ihsanalhafiz/Krakatau-Board-v1.3/PCBWay-BOM KrakatauBoardv1.3.xlsx

 |  |  | Bill of Materials Krakatau Board v1.3
Item # | *Designator | *Qty | Manufacturer | *Mfg Part # | Description / Value | *Package/Footprint | Type | Your Instructions / Notes
1 | U1 | 1 | STMicroelectronics | STM32F413VHT6 | IC MCU 32BIT 1.5MB FLASH 100LQFP | 100-LQFP | SMD |  | https://www.digikey.com/product-detail/en/stmicroelectronics/STM32F413VHT6/497-17010-ND/6564702
2 | SW1 | 1 | E-Switch | TL3342F160QG/TR | SWITCH TACTILE SPST-NO 0.05A 12V |  | SMD |  | https://www.digikey.com/product-detail/en/e-switch/TL3342F160QG-TR/EG2531CT-ND/379004
3 | C1,C2 | 2 | Murata Electronics | GRM155R61A225KE95D | CAP CER 2.2UF 10V X5R 0402 | 0402 | SMD |  | https://www.digikey.com/product-detail/en/murata-electronics/GRM155R61A225KE95D/490-10451-1-ND/5026361
4 | BT1, BT2 | 2 | Harwin Inc. | S8411-45R | BATTERY HOLDER COIN 12MM SMD |  | SMD | Please include battery CR1220 in PCB Board | https://www.digikey.com/product-detail/en/harwin-inc/S8411-45R/952-1745-1-ND/3131073
5 | Y1 | 1 | ECS Inc. | ECS-250-20-33-CKM-TR | CRYSTAL 25.0000MHZ 20PF SMD | 4-SMD | SMD |  | https://www.digikey.com/product-detail/en/ecs-inc/ECS-250-20-33-CKM-TR/XC1817CT-ND/2781942
6 | Y2 | 1 | ECS Inc. | ECS-.327-12.5-34B-TR | CRYSTAL 32.7680KHZ 12.5PF SMD | 2-SMD | SMD |  | https://www.digikey.com/product-detail/en/ecs-inc/ECS-327-12-5-34B-TR/XC1617CT-ND/1693786
7 | C4, C5 | 2 | Murata Electronics | GJM1555C1H200JB01D | CAP CER 20PF 50V C0G/NP0 0402 | 0402 | SMD |  | https://www.digikey.com/product-detail/en/murata-electronics/GJM1555C1H200JB01D/490-3120-1-ND/702386
8 | C6,C7 | 2 | Murata Electronics | GCM1555C1H120FA16J | CAP CER 12PF 50V C0G/NP0 0402 | 0402 | SMD |  | https://www.digikey.com/product-detail/en/murata-electronics/GCM1555C1H120FA16J/490-16459-1-ND/7363441
9 | C8 | 1 | KEMET | C1210T475K5RAC7800 | CAP CER 4.7UF 50V X7R 1210 | 1210 | SMD |  | https://www.digikey.com/product-detail/en/kemet/C1210T475K5RAC7800/399-20366-1-ND/9925808
10 | C3, C9, C10, C11, C12, C13, C14, C15, C16, C17, C18, C19, C22, C23, C24, C31, C47, C49, C59, C60, C61 | 21 | KEMET | C0402T104K4RAC7867 | CAP CER 0.1UF 16V X7R 0402 | 0402 | SMD |  | https://www.digikey.com/product-detail/en/kemet/C0402T104K4RAC7867/399-17387-1-ND/8570354
11 | C20, C21, C32, C34, C35, C36, C37, C38, C39, C40, C41, C42, C43 | 13 | KEMET | C0603C105K8RACAUTO | CAP CER 0603 1UF 10V X7R 10% | 0603 | SMD |  | https://www.digikey.com/product-detail/en/kemet/C0603C105K8RACAUTO/399-17705-1-ND/8635856
12 | R1, R9, R10,R11,R12, R13, R14 | 7 | Vishay Dale | TNPW040210K0BETD | RES 10K OHM 0.1% 1/16W 0402 | 0402 | SMD |  | https://www.digikey.com/product-detail/en/vishay-dale/TNPW040210K0BETD/541-3559-1-ND/7354920
13 | U2 | 1 | Texas Instruments | LM3671MF-3.3/NOPB | IC REG BUCK 3.3V 600MA SOT23-5 | SOT23-5 | SMD |  | https://www.digikey.com/product-detail/en/texas-instruments/LM3671MF-3-3-NOPB/LM3671MF-3-3-NOPBCT-ND/1590190
14 | R2, R3, R5 | 3 | Vishay Dale | TNPW0402100KBETD | RES 100K OHM 0.1% 1/16W 0402 | 0402 | SMD |  | https://www.digikey.com/product-detail/en/vishay-dale/TNPW0402100KBETD/541-3558-1-ND/7354919
15 | C25 | 1 | KEMET | C0805C475K4RACTU | CAP CER 4.7UF 16V X7R 0805 | 0805 | SMD |  | https://www.digikey.com/product-detail/en/kemet/C0805C475K4RACTU/399-7415-1-ND/3317449
16 | C26 | 1 | KEMET | C0805C106M8RACAUTO | CAP CER 10UF 10V X7R 0805 | 0805 | SMD |  | https://www.digikey.com/product-detail/en/kemet/C0805C106M8RACAUTO/399-15690-1-ND/7427570
17 | U3 | 1 | Texas Instruments | LMR33630ADDAR | IC REG BUCK ADJUSTABLE 3A 8SOPWR | 8SOPWR | SMD |  | https://www.digikey.com/product-detail/en/texas-instruments/LMR33630ADDAR/296-49763-1-ND/9462677
18 | C27 | 1 | Würth Elektronik | 865230542002 | CAP 10 UF 20% 35 V | Radial | SMD |  | https://www.digikey.com/product-detail/en/w%C3%BCrth-elektronik/865230542002/732-8295-1-ND/5728252
19 | C28 | 1 | KEMET | C0805C224K5RACAUTO | CAP CER 0.22UF 50V X7R 0805 | 0805 | SMD |  | https://www.digikey.com/product-detail/en/kemet/C0805C224K5RACAUTO/399-6949-1-ND/3314457
20 | C29, C30, C63, C64 | 4 | Taiyo Yuden | LMK212BBJ226MD-T | CAP CER 22UF 10V X5R 0805 | 0805 | SMD |  | https://www.digikey.com/product-detail/en/taiyo-yuden/LMK212BBJ226MD-T/587-5917-1-ND/7675037
21 | R4 | 1 | TE Connectivity Passive Product | RN73C1E24K9BTD | RES SMD 24.9KOHM 0.1% 1/16W 0402 | 0402 | SMD |  | https://www.digikey.com/product-detail/en/te-connectivity-passive-product/RN73C1E24K9BTD/A124622CT-ND/6558382
22 | L1, L2 | 2 | Würth Elektronik | 78438356022 | FIXED IND 2.2UH 4.7A 35 MOHM SMD |  | SMD |  | https://www.digikey.com/product-detail/en/w%C3%BCrth-elektronik/78438356022/732-11314-1-ND/6833773
23 | D2, D5 | 2 | Nexperia USA Inc. | PMEG3050EP,115 | DIODE SCHOTTKY 30V 5A SOD128 | SOD128 | SMD |  | https://www.digikey.com/product-detail/en/nexperia-usa-inc/PMEG3050EP-115/1727-5317-1-ND/2676793
24 | U4 | 1 | Texas Instruments | REF2933AIDBZR | IC VREF SERIES 2% SOT23-3 | SOT23-3 | SMD |  | https://www.digikey.com/product-detail/en/texas-instruments/REF2933AIDBZR/296-41482-1-ND/5222875
25 | C33 | 1 | Murata Electronics | GRM155R71A474KE01D | CAP CER 0.47UF 10V X7R 0402 | 0402 | SMD |  | https://www.digikey.com/product-detail/en/murata-electronics/GRM155R71A474KE01D/490-14366-1-ND/6606827
26 | U5 | 1 | Fanstel Corp. | BT832XE | RX TXRX MOD BLE 5 U.FL SMD |  | SMD |  | https://www.digikey.com/product-detail/en/fanstel-corp/BT832XE/1914-1016-1-ND/8323669
27 | R6 | 1 | Keystone Electronics | 5112 | 0402 JUMPER ON TAPE AND REEL | 0402 | SMD |  | https://www.digikey.com/product-detail/en/keystone-electronics/5112/36-5112-1-ND/9921855
28 | U6, U7 | 2 | Texas Instruments | MAX232ECDW | IC TRANSCEIVER FULL 2/2 16SOIC | 16SOIC | SMD |  | https://www.digikey.com/product-detail/en/texas-instruments/MAX232ECDW/296-33358-5-ND/1511009
29 | U8 | 1 | FTDI, Future Technology Devices International Ltd | FT234XD-R | IC USB SERIAL BASIC UART 12DFN | 12-DFN | SMD |  | https://www.digikey.com/product-detail/en/ftdi-future-technology-devices-international-ltd/FT234XD-R/768-1178-1-ND/3904926
30 | L3 | 1 | Würth Elektronik | 742792651 | FERRITE BEAD 600 OHM 0603 1LN | 0603 | SMD |  | https://www.digikey.com/product-detail/en/w%C3%BCrth-elektronik/742792651/732-1593-1-ND/1639537
31 | R7, R8 | 2 | TE Connectivity Passive Product | CRGP0402F27R | CRGP 0402 27R 1% | 0402 | SMD |  | https://www.digikey.com/product-detail/en/te-connectivity-passive-product/CRGP0402F27R/A130336CT-ND/8578168
32 | C44, C45 | 2 | KEMET | C0402C470K5GACTU | CAP CER 47PF 50V C0G/NP0 0402 | 0402 | SMD |  | https://www.digikey.com/product-detail/en/kemet/C0402C470K5GACTU/399-7796-1-ND/3471519
33 | C46, C50 | 2 | KEMET | C0402C103M5RACTU | CAP CER 10000PF 50V X7R 0402 | 0402 | SMD |  | https://www.digikey.com/product-detail/en/kemet/C0402C103M5RACTU/399-7760-1-ND/3471483
34 | C48 | 1 | Würth Elektronik | 885012105008 | CAP CER 4.7UF 6.3V X5R 0402 | 0402 | SMD |  | https://www.digikey.com/product-detail/en/w%C3%BCrth-elektronik/885012105008/732-7485-1-ND/5454112
35 | U9 | 1 | Maxim Integrated | MAX5490VB10000+T | RES NTWRK 2 RES MULT OHM TO236-3 | TO236-3 | SMD |  | https://www.digikey.com/product-detail/en/stmicroelectronics/TESEO-LIV3F/497-18163-1-ND/9556693
36 | U10 | 1 | STMicroelectronics | TESEO-LIV3F | RF RCVR GNSS/GPS 1.575GHZ 18LCC |  | SMD |  | https://www.digikey.com/product-detail/en/stmicroelectronics/TESEO-LIV3F/497-18163-1-ND/9556693
37 | L4 | 1 | Murata Electronics | LQG15HS27NJ02D | FIXED IND 27NH 350MA 460 MOHM | 0402 | SMD |  | https://www.digikey.com/product-detail/en/murata-electronics/LQG15HS27NJ02D/490-2628-1-ND/662908
38 | C51, C52, C53, C54. C55 | 5 | KEMET | C0402C560K5RAC7867 | CAP CER 56PF 50V X7R 0402 | 0402 | SMD |  | https://www.digikey.com/product-detail/en/kemet/C0402C560K5RAC7867/399-C0402C560K5RAC7867CT-ND/11504529
39 | C56, C57 | 2 | Knowles Novacap | C04BL121X-5SN-X0T | CAP CER 120PF 50V 0402 | 0402 | SMD |  | https://www.digikey.com/product-detail/en/knowles-novacap/C04BL121X-5SN-X0T/1761-1074-1-ND/7596237
40 | FL1 | 1 | Taiyo Yuden | F6QA1G582H2JM-J | FILTER SAW 1.582GHZ 5SMD |  | SMD |  | https://www.digikey.com/product-detail/en/taiyo-yuden/F6QA1G582H2JM-J/587-3990-1-ND/4963980
41 | U11 | 1 | Infineon Technologies | BGA725L6E6327FTSA1 | IC AMP GPS 1.55-1.615GHZ TSLP6-2 | TSLP6-2 | SMD |  | https://www.digikey.com/product-detail/en/infineon-technologies/BGA725L6E6327FTSA1/BGA725L6E6327FTSA1CT-ND/3911501
42 | L5 | 1 | Murata Electronics | LQW15AN5N6C10D | FIXED IND 5.6NH 800MA 51 MOHM | 0402 | SMD |  | https://www.digikey.com/product-detail/en/murata-electronics/LQW15AN5N6C10D/490-6833-1-ND/3846030
43 | C58 | 1 | KEMET | C0402C102K5RACTU | CAP CER 1000PF 50V X7R 0402 | 0402 | SMD |  | https://www.digikey.com/product-detail/en/kemet/C0402C102K5RACTU/399-1032-1-ND/411307
44 | Y3, Y4, Y5 | 3 | Hirose Electric Co Ltd | U.FL-R-SMT-1(10) | CONN U.FL RCPT STR 50 OHM SMD |  | SMD |  | https://www.digikey.com/product-detail/en/hirose-electric-co-ltd/U-FL-R-SMT-1-10/H11891CT-ND/2504612
45 | U12 | 1 | Maxim Integrated | DS3231SN#T&R | IC RTC CLK/CALENDAR I2C 16-SOIC | 16-SOIC | SMD |  | https://www.digikey.com/product-detail/en/maxim-integrated/DS3231SN-T-R/DS3231SN-T-RCT-ND/3894827
46 | U13 | 1 | Microchip Technology | 24LC01BT-E/OT | IC EEPROM 1K I2C 400KHZ SOT23-5 | SOT23-5 | SMD |  | https://www.digikey.com/product-detail/en/microchip-technology/24LC01BT-E-OT/24LC01BT-E-OTCT-ND/7065550
47 | U14 | 1 | Linear Technology/Analog Devices | LTC4151IMS#TRPBF | IC CURRENT MONITOR(12BIT) 10MSOP | 10MSOP | SMD |  | https://www.digikey.com/product-detail/en/linear-technology-analog-devices/LTC4151IMS-TRPBF/LTC4151IMS-TRPBFCT-ND/8258439
48 | RS1 | 1 | Stackpole Electronics Inc | HCSM2818FT20L0 | RES 0.02 OHM 5W 1% 2818 SMD | 2818 | SMD |  | https://www.digikey.com/product-detail/en/stackpole-electronics-inc/HCSM2818FT20L0/HCSM2818FT20L0CT-ND/9557201
49 | R15, R16 | 2 | Vishay Dale | TNPW04022K00BEED | RES 2K OHM 0.1% 1/16W 0402 | 0402 | SMD |  | https://www.digikey.com/product-detail/en/vishay-dale/TNPW04022K00BEED/TNP2-00KDACT-ND/1857046
50 | T1 | 1 | Vishay Siliconix | SUM110P06-07L-E3 | MOSFET P-CH 60V 110A D2PAK | D2PAK | SMD |  | https://www.digikey.com/product-detail/en/vishay-siliconix/SUM110P06-07L-E3/SUM110P06-07L-E3CT-ND/1656732
51 | R17 | 1 | Vishay Dale | TNPW0603100KBETA | RES 100K OHM 0.1% 1/10W 0603 | 0603 | SMD |  | https://www.digikey.com/product-detail/en/vishay-dale/TNPW0603100KBETA/541-3570-1-ND/7354930
52 | D3 | 1 | Diodes Incorporated | BZT52C12-13-F | DIODE ZENER 12V 500MW SOD123 | SOD123 | SMD |  | https://www.digikey.com/product-detail/en/diodes-incorporated/BZT52C12-13-F/BZT52C1213-FDICT-ND/1852057
53 | U15 | 1 | ON Semiconductor | MMBT2907ALT1G | TRANS PNP 60V 0.6A SOT23 | SOT23 | SMD |  | https://www.digikey.com/product-detail/en/on-semiconductor/MMBT2907ALT1G/MMBT2907ALT1GOSCT-ND/1139812
54 | D4 | 1 | Infineon Technologies | ESD234B1W0201E6327XTSA1 | TVS DIODES |  | SMD |  | https://www.digikey.com/product-detail/en/infineon-technologies/ESD234B1W0201E6327XTSA1/ESD234B1W0201E6327XTSA1CT-ND/9974934
55 | R18 | 1 | Vishay Dale | TNPW040220K0BEED | RES 20K OHM 0.1% 1/16W 0402 | 0402 | SMD |  | https://www.digikey.com/product-detail/en/vishay-dale/TNPW040220K0BEED/TNP20-0KDACT-ND/1857043
56 | R19, R20 | 2 | Vishay Dale | CRCW0402560KFKED | RES SMD 560K OHM 1% 1/16W 0402 | 0402 | SMD |  | https://www.digikey.com/product-detail/en/vishay-dale/CRCW0402560KFKED/541-560KLCT-ND/1183436
57 | R21 | 1 | Vishay Dale | CRCW04020000Z0EDHP | RES SMD 0 OHM JUMPER 1/5W 0402 | 0402 | SMD |  | https://www.digikey.com/product-detail/en/vishay-dale/CRCW04020000Z0EDHP/541-0-0YBCT-ND/2223008
58 | U16 | 1 | STMicroelectronics | IIS328DQTR | ACCELEROMETER 2-8G I2C/SPI 24QFN | 24QFN | SMD |  | https://www.digikey.com/product-detail/en/stmicroelectronics/IIS328DQTR/497-15701-1-ND/5267987
59 | C62 | 1 | KEMET | C0402C106M9PAC7867 | CAP CER 10UF 6.3V X5R 0402 | 0402 | SMD |  | https://www.digikey.com/product-detail/en/kemet/C0402C106M9PAC7867/399-13069-1-ND/5767556
60 | J12 | 1 | Samtec Inc. | CLP-110-02-FM-D-P-TR | CONN RCPT 20POS 0.05 GOLD SMD |  | SMD |  | https://www.digikey.com/product-detail/en/samtec-inc/CLP-110-02-FM-D-P-TR/CLP-110-02-FM-D-P-TR-ND/6704150
61 | J10 | 1 | Würth Elektronik | 693071020811 | SMT MICRO SD CARD CONNECTOR, PUS |  | SMD |  | https://www.digikey.com/product-detail/en/w%C3%BCrth-elektronik/693071020811/732-693071020811CT-ND/11631970
62 | J1, J2 | 2 | Samtec Inc. | MMCX-P-P-H-ST-TH1 | CONN MMCX PLUG STR 50 OHM PCB |  | Through Hole |  | https://www.digikey.com/product-detail/en/samtec-inc/MMCX-P-P-H-ST-TH1/SAM10618-ND/6561612
63 | J3, J5, J11, J13 | 4 | Sullins Connector Solutions | SWR25X-NRTC-S02-RB-BA | CONN HEADER R/A 2POS 2.54MM |  | Through Hole |  | https://www.digikey.com/product-detail/en/sullins-connector-solutions/SWR25X-NRTC-S02-RB-BA/S9499-ND/2769660
64 | J4, J6, J7, J14 | 4 | Sullins Connector Solutions | SWR25X-NRTC-S03-RB-BA | CONN HEADER R/A 3POS 2.54MM |  | Through Hole |  | https://www.digikey.com/product-detail/en/sullins-connector-solutions/SWR25X-NRTC-S03-RB-BA/S9403-ND/2769661
65 | J9 | 1 | Sullins Connector Solutions | SWR25X-NRTC-S04-ST-BA | CONN HEADER VERT 4POS 2.54MM |  | Through Hole |  | https://www.digikey.com/product-detail/en/sullins-connector-solutions/SWR25X-NRTC-S04-ST-BA/S9410-ND/2769654
66 | J8 | 1 | Würth Elektronik | 61300511121 | CONN HEADER VERT 5POS 2.54MM |  | Through Hole |  | https://www.digikey.com/product-detail/en/w%C3%BCrth-elektronik/61300511121/732-5318-ND/4846831
67 | J15 | 1 | Würth Elektronik | 61300311121 | CONN HEADER VERT 3POS 2.54MM |  | Through Hole |  | https://www.digikey.com/product-detail/en/w%C3%BCrth-elektronik/61300311121/732-5316-ND/4846825
