ihsanalhafiz/Krakatau-Board-v1.3/Krakatau Board v1.3.brd

## EAGLE design Krakatau Board v1.3.brd (2020-05-09)

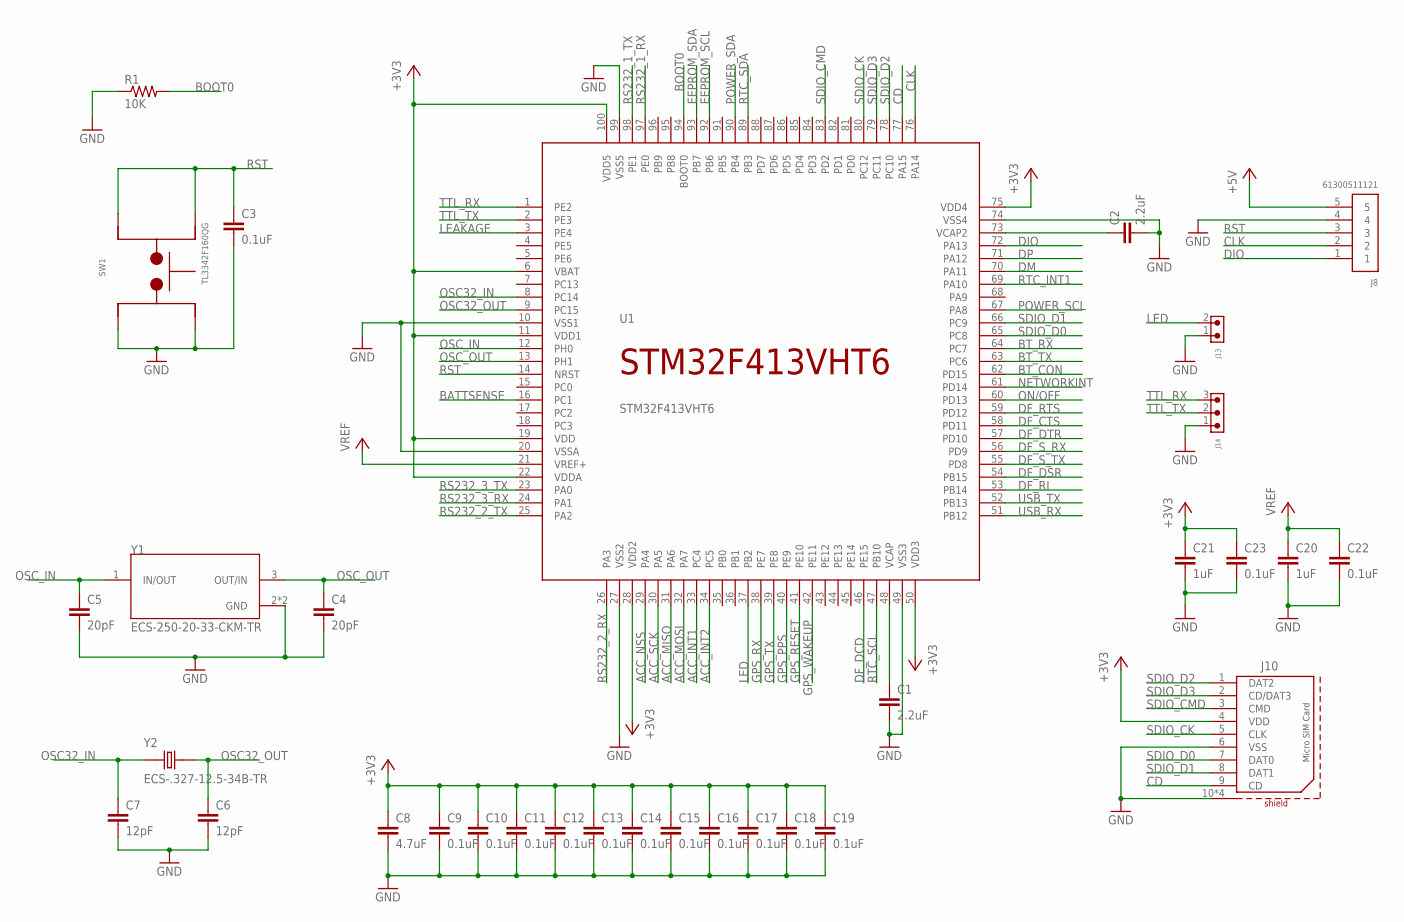
[picture p1: schematic Krakatau Board v1.3.sch, sheet 1, Microcontroller STM32F413VHT6]

Parts:
C1, C2: 2.2uF; CAPC1005X50N-0402-KEMET
C3, C9, C10, C11, C12, C13, C14, C15, C16, C17, C18, C19, C22, C23: 0.1uF; CAPC1005X50N-0402-KEMET
C4, C5: 20pF; CAPC1005X50N-0402-KEMET
C6, C7: 12pF; CAPC1005X50N-0402-KEMET
C8: 4.7uF; CAPC3225X90N-1210-KEMET
C20, C21: 1uF; CAPC1608X80N-0603-KEMET
J8: 61300511121
J10: 693071020811
J13: 61900211121
J14: 61900311121
R1: 10K; RESC1005X35N-0402-VISHAYDALE
SW1: TL3342F160QG; SW_TL3342F160QG
U1: STM32F413VHT6; QFP50P1590X1590X160-100N
Y1: ECS-250-20-33-CKM-TR; XTAL_ECS-250-20-33-CKM-TR
Y2: ECS-.327-12.5-34B-TR; XTAL_ECS-.327-12.5-34B-TR

Connections:
+3V3: C8.1, C9.1, C10.1, C11.1, C12.1, C13.1, C14.1, C15.1, C16.1, C17.1, C18.1, C19.1, C21.1, C23.1, J10.4 (VDD), U1.6 (VBAT), U1.11 (VDD1), U1.19 (VDD), U1.22 (VDDA), U1.28 (VDD2), U1.50 (VDD3), U1.75 (VDD4), U1.100 (VDD5); also elsewhere on the board
+5V: J8.5; also elsewhere on the board
ACC_INT1: U1.33 (PC4); also elsewhere on the board
ACC_INT2: U1.34 (PC5); also elsewhere on the board
ACC_MISO: U1.31 (PA6); also elsewhere on the board
ACC_MOSI: U1.32 (PA7); also elsewhere on the board
ACC_NSS: U1.29 (PA4); also elsewhere on the board
ACC_SCK: U1.30 (PA5); also elsewhere on the board
BATTSENSE: U1.16 (PC1); also elsewhere on the board
BOOT0: R1.2, U1.94 (BOOT0)
BT_CON: U1.62 (PD15); also elsewhere on the board
BT_RX: U1.64 (PC7); also elsewhere on the board
BT_TX: U1.63 (PC6); also elsewhere on the board
CD: J10.9 (CD), U1.77 (PA15)
CLK: J8.2, U1.76 (PA14)
DF_CTS: U1.58 (PD11); also elsewhere on the board
DF_DCD: U1.46 (PE15); also elsewhere on the board
DF_DSR: U1.54 (PB15); also elsewhere on the board
DF_DTR: U1.57 (PD10); also elsewhere on the board
DF_RI: U1.53 (PB14); also elsewhere on the board
DF_RTS: U1.59 (PD12); also elsewhere on the board
DF_S_RX: U1.56 (PD9); also elsewhere on the board
DF_S_TX: U1.55 (PD8); also elsewhere on the board
DIO: J8.1, U1.72 (PA13)
DM: U1.70 (PA11)
DP: U1.71 (PA12)
EEPROM_SCL: U1.92 (PB6); also elsewhere on the board
EEPROM_SDA: U1.93 (PB7); also elsewhere on the board
GND: C1.2, C2.2, C3.2, C4.2, C5.2, C6.2, C7.2, C8.2, C9.2, C10.2, C11.2, C12.2, C13.2, C14.2, C15.2, C16.2, C17.2, C18.2, C19.2, C20.2, C21.2, C22.2, C23.2, J8.4, J10.6 (VSS), J10.10 (SHIELD), J10.11 (SHIELD), J10.12 (SHIELD), J10.13 (SHIELD), J13.1, J14.1, R1.1, SW1.1, SW1.2, U1.10 (VSS1), U1.20 (VSSA), U1.27 (VSS2), U1.49 (VSS3), U1.74 (VSS4), U1.99 (VSS5), Y1.2 (GND), Y1.4 (GND); also elsewhere on the board
GPS_PPS: U1.40 (PE9); also elsewhere on the board
GPS_RESET: U1.41 (PE10); also elsewhere on the board
GPS_RX: U1.38 (PE7); also elsewhere on the board
GPS_TX: U1.39 (PE8); also elsewhere on the board
GPS_WAKEUP: U1.42 (PE11); also elsewhere on the board
LEAKAGE: U1.3 (PE4); also elsewhere on the board
LED: J13.2, U1.37 (PB2)
unnamed: C2.1, U1.73 (VCAP2)
unnamed: C1.1, U1.48 (VCAP)
NETWORKINT: U1.61 (PD14); also elsewhere on the board
ON/OFF: U1.60 (PD13); also elsewhere on the board
OSC32_IN: C7.1, U1.8 (PC14), Y2.1
OSC32_OUT: C6.1, U1.9 (PC15), Y2.2
OSC_IN: C5.1, U1.12 (PH0), Y1.1 (IN/OUT)
OSC_OUT: C4.1, U1.13 (PH1), Y1.3 (OUT/IN)
POWER_SCL: U1.67 (PA8); also elsewhere on the board
POWER_SDA: U1.90 (PB4); also elsewhere on the board
RS232_1_RX: U1.97 (PE0); also elsewhere on the board
RS232_1_TX: U1.98 (PE1); also elsewhere on the board
RS232_2_RX: U1.26 (PA3); also elsewhere on the board
RS232_2_TX: U1.25 (PA2); also elsewhere on the board
RS232_3_RX: U1.24 (PA1); also elsewhere on the board
RS232_3_TX: U1.23 (PA0); also elsewhere on the board
RST: C3.1, J8.3, SW1.3, SW1.4, U1.14 (NRST)
RTC_INT1: U1.69 (PA10); also elsewhere on the board
RTC_SCL: U1.47 (PB10); also elsewhere on the board
RTC_SDA: U1.89 (PB3); also elsewhere on the board
SDIO_CK: J10.5 (CLK), U1.80 (PC12)
SDIO_CMD: J10.3 (CMD), U1.83 (PD2)
SDIO_D0: J10.7 (DAT0), U1.65 (PC8)
SDIO_D1: J10.8 (DAT1), U1.66 (PC9)
SDIO_D2: J10.1 (DAT2), U1.78 (PC10)
SDIO_D3: J10.2 (CD/DAT3), U1.79 (PC11)
TTL_RX: J14.3, U1.1 (PE2)
TTL_TX: J14.2, U1.2 (PE3)
USB_RX: U1.51 (PB12); also elsewhere on the board
USB_TX: U1.52 (PB13); also elsewhere on the board
VCC: C20.1, C22.1, U1.21 (VREF+); also elsewhere on the board

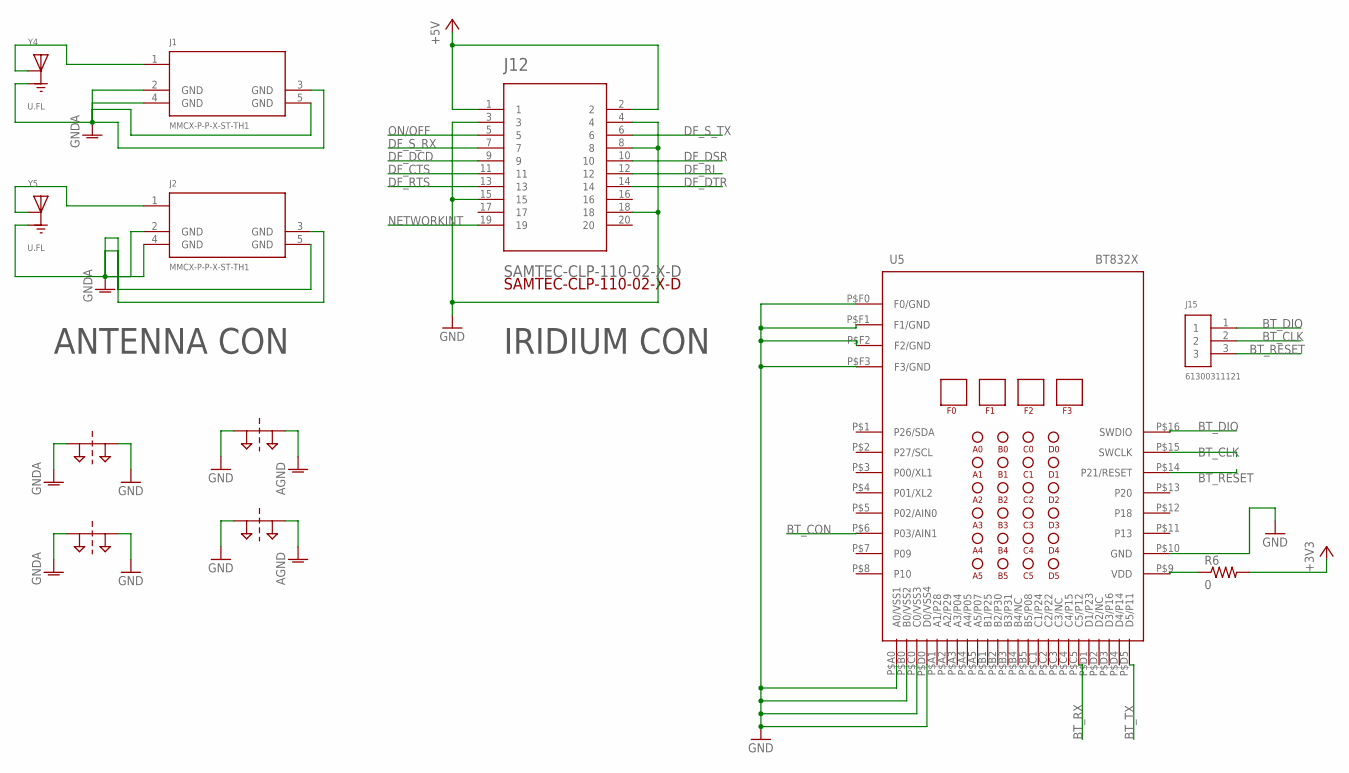
[picture p2: schematic Krakatau Board v1.3.sch, sheet 2]

Parts:
J1, J2: MMCX-P-P-X-ST-TH1
J12: SAMTEC-CLP-110-02-X-D
J15: 61300311121
R6: 0; RESC1005X30N
SUPPLY4, SUPPLY5, SUPPLY6, SUPPLY7: 2PT_GND_TIE
U5: BT832X
Y4, Y5: U.FL; HRS_U.FL-R-SMT-1(10)

Connections:
+3V3: R6.2; also elsewhere on the board
+5V: J12.1, J12.2; also elsewhere on the board
AGND: SUPPLY5.P$2, SUPPLY6.P$2; also elsewhere on the board
BT_CLK: J15.2, U5.P$15 (SWCLK)
BT_CON: U5.P$6 (P03/AIN1); also elsewhere on the board
BT_DIO: J15.1, U5.P$16 (SWDIO)
BT_RESET: J15.3, U5.P$14 (P21/RESET)
BT_RX: U5.P$C5 (C5/P12); also elsewhere on the board
BT_TX: U5.P$D5 (D5/P11); also elsewhere on the board
DF_CTS: J12.11; also elsewhere on the board
DF_DCD: J12.9; also elsewhere on the board
DF_DSR: J12.10; also elsewhere on the board
DF_DTR: J12.14; also elsewhere on the board
DF_RI: J12.12; also elsewhere on the board
DF_RTS: J12.13; also elsewhere on the board
DF_S_RX: J12.7; also elsewhere on the board
DF_S_TX: J12.6; also elsewhere on the board
GND: J12.3, J12.4, J12.8, J12.15, J12.18, SUPPLY4.P$2, SUPPLY5.P$1, SUPPLY6.P$1, SUPPLY7.P$2, U5.P$10 (GND), U5.P$A0 (A0/VSS1), U5.P$B0 (B0/VSS2), U5.P$C0 (C0/VSS3), U5.P$D0 (D0/VSS4), U5.P$F0 (F0/GND), U5.P$F1 (F1/GND), U5.P$F2 (F2/GND), U5.P$F3 (F3/GND); also elsewhere on the board
GNDA: J1.2 (GND), J1.3 (GND), J1.4 (GND), J1.5 (GND), J2.2 (GND), J2.3 (GND), J2.4 (GND), J2.5 (GND), SUPPLY4.P$1, SUPPLY7.P$1, Y4.1 (GND), Y4.3 (GND), Y5.1 (GND), Y5.3 (GND)
unnamed: R6.1, U5.P$9 (VDD)
unnamed: J1.1, Y4.2 (SIG)
unnamed: J2.1, Y5.2 (SIG)
NETWORKINT: J12.19; also elsewhere on the board
ON/OFF: J12.5; also elsewhere on the board

Notes on the sheet:
ANTENNA CON
IRIDIUM CON

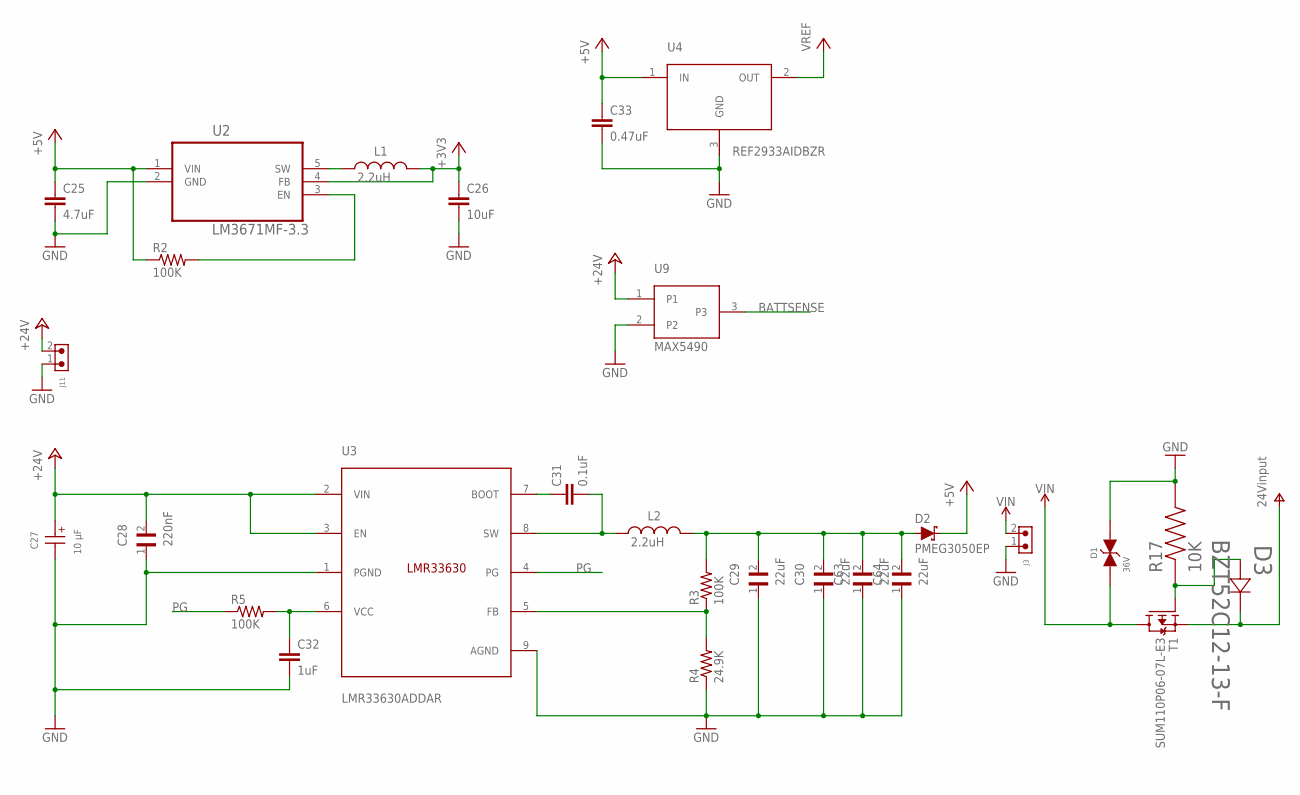
[picture p3: schematic Krakatau Board v1.3.sch, sheet 3]

Parts:
C25: 4.7uF; CAPC2113X90N-0805-KEMET
C26: 10uF; CAPC2113X90N-0805-KEMET
C27: 10 µF; WCAP-AS5H_5X5.5(DXL)
C28: 220nF; CAPC2012X100N
C29, C30, C63, C64: 22uF; CAPC2113X95N
C31: 0.1uF; CAPC1005X50N-0402-KEMET
C32: 1uF; CAPC1608X80N-0603-KEMET
C33: 0.47uF; CAPC1005X50N-0402-KEMET
D1: 36V; WE-TVSP_DO-214AB_BIDIRECTIONAL
D2: PMEG3050EP; SODFL4725X110N
D3: BZT52C12-13-F; SOD123_DIO
J3, J11: 61900211021
L1, L2: 2.2uH; WE-MAIA_4020
R2, R3, R5: 100K; RESC1005X35N-0402-VISHAYDALE
R4: 24.9K; RESC1005X30N
R17: 10K; RESC1608X55N
T1: SUM110P06-07L-E3; TO-263AB_SUM
U2: LM3671MF-3.3; SOT95P284X122-5N
U3: LMR33630ADDAR; SOIC127P600X170-9T260X310N
U4: REF2933AIDBZR; SOT95P237X112-3N
U9: MAX5490; SOT95P237X110-3

Connections:
+3V3: C26.1, L1.2, U2.4 (FB); also elsewhere on the board
+5V: C25.1, C33.1, D2.C, R2.1, U2.1 (VIN), U4.1 (IN); also elsewhere on the board
+24V: C27.1 (+), C28.2, J11.2, U3.2 (VIN), U3.3 (EN), U9.1; also elsewhere on the board
BATTSENSE: U9.3; also elsewhere on the board
GND: C25.2, C26.2, C27.2 (-), C28.1, C29.1, C30.1, C32.2, C33.2, C63.1, C64.1, D1.2, J3.1, J11.1, R4.1, R17.2, U2.2 (GND), U3.1 (PGND), U3.9 (AGND), U4.3 (GND), U9.2; also elsewhere on the board
unnamed: L1.1, U2.5 (SW)
unnamed: C31.1, U3.7 (BOOT)
unnamed: C29.2, C30.2, C63.2, C64.2, D2.A, L2.2, R3.2
unnamed: C32.1, R5.2, U3.6 (VCC)
unnamed: C31.2, L2.1, U3.8 (SW)
unnamed: R3.1, R4.2, U3.5 (FB)
unnamed: D3.2, R17.1, T1.1 (G)
unnamed: R2.2, U2.3 (EN)
PG: R5.1, U3.4 (PG)
V+: D3.1, T1.3 (S); also elsewhere on the board
VCC: U4.2 (OUT); also elsewhere on the board
VIN: D1.1, J3.2, T1.2 (D)

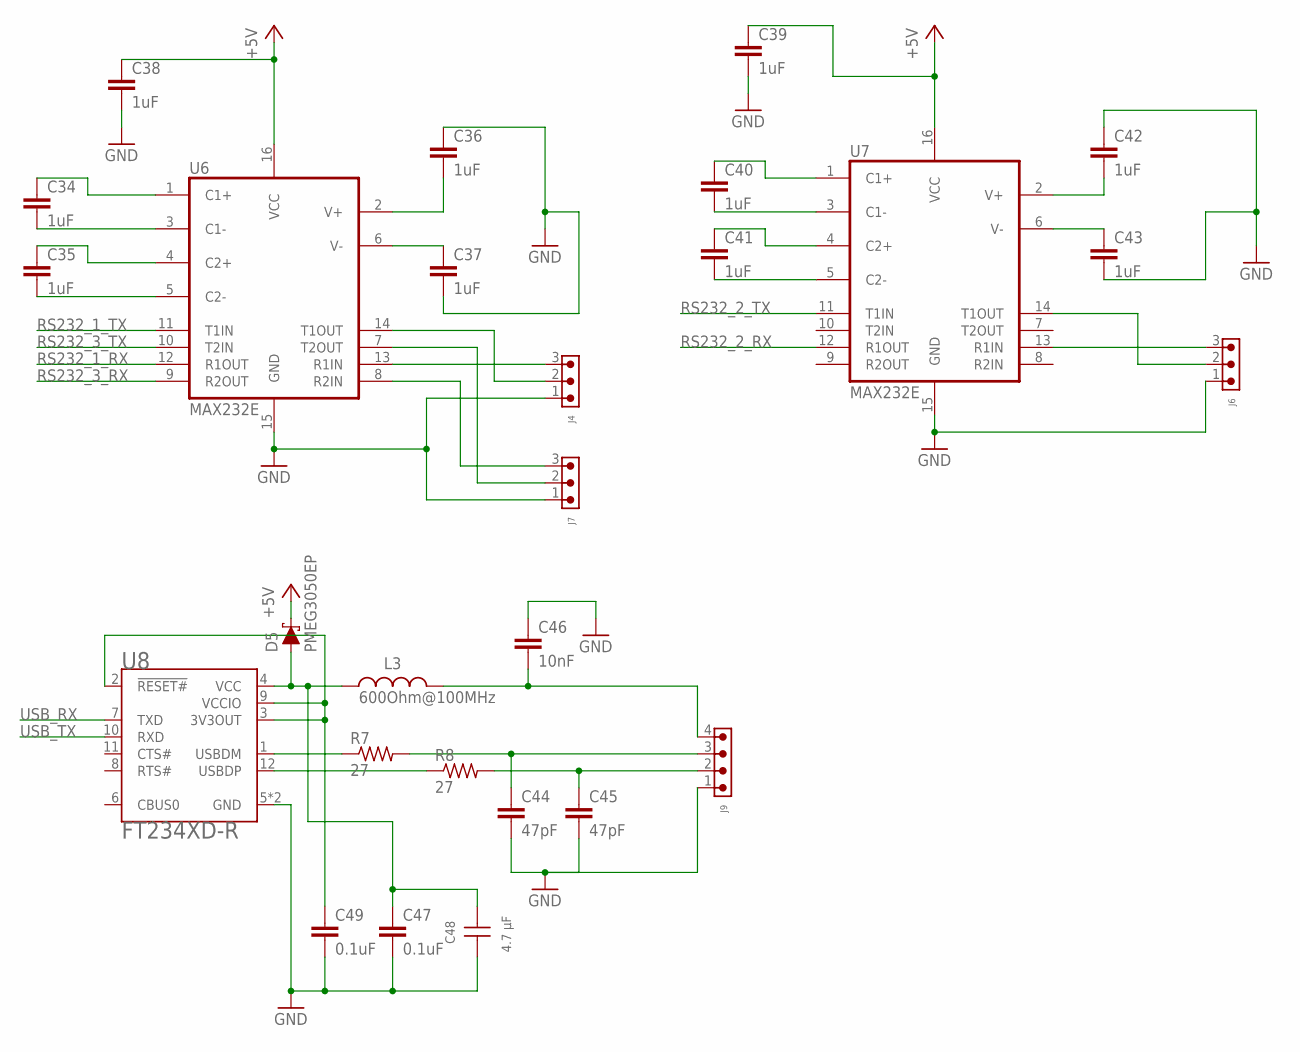
[picture p4: schematic Krakatau Board v1.3.sch, sheet 4]

Parts:
C34, C35, C36, C37, C38, C39, C40, C41, C42, C43: 1uF; CAPC1608X80N-0603-KEMET
C44, C45: 47pF; CAPC1005X50N-0402-KEMET
C46: 10nF; CAPC1005X50N-0402-KEMET
C47, C49: 0.1uF; CAPC1005X50N-0402-KEMET
C48: 4.7 µF; WCAP-CSGP_0402
D5: PMEG3050EP; SODFL4725X110N
J4, J6, J7: 61900311021
J9: 61900411121
L3: 600Ohm@100MHz; WE-CBF_0603(W=2.6)
R7, R8: 27; RESC1005X30N
U6, U7: MAX232E; SOIC127P1030X265-16N
U8: FT234XD-R; SON45P300X300X75-13N

Connections:
+5V: C38.1, C39.1, D5.C, U6.16 (VCC), U7.16 (VCC); also elsewhere on the board
GND: C36.1, C37.2, C38.2, C39.2, C42.1, C43.2, C44.2, C45.2, C46.1, C47.2, C48.1, C49.2, J4.1, J6.1, J7.1, J9.1, U6.15 (GND), U7.15 (GND), U8.5 (GND), U8.13 (GND); also elsewhere on the board
unnamed: J6.2, U7.14 (T1OUT)
unnamed: J6.3, U7.13 (R1IN)
unnamed: C34.1, U6.1 (C1+)
unnamed: C34.2, U6.3 (C1-)
unnamed: C35.1, U6.4 (C2+)
unnamed: J4.2, U6.14 (T1OUT)
unnamed: J4.3, U6.13 (R1IN)
unnamed: J7.2, U6.7 (T2OUT)
unnamed: J7.3, U6.8 (R2IN)
unnamed: C35.2, U6.5 (C2-)
unnamed: C36.2, U6.2 (V+)
unnamed: C37.1, U6.6 (V-)
unnamed: C40.2, U7.3 (C1-)
unnamed: C40.1, U7.1 (C1+)
unnamed: C41.1, U7.4 (C2+)
unnamed: C41.2, U7.5 (C2-)
unnamed: C43.1, U7.6 (V-)
unnamed: C42.2, U7.2 (V+)
unnamed: R7.1, U8.1 (USBDM)
unnamed: R8.1, U8.12 (USBDP)
unnamed: C44.1, J9.3, R7.2
unnamed: C45.1, J9.2, R8.2
unnamed: C46.2, J9.4, L3.2
unnamed: C49.1, U8.2 (!RESET#), U8.3 (3V3OUT), U8.9 (VCCIO)
unnamed: C47.1, C48.2, D5.A, L3.1, U8.4 (VCC)
RS232_1_RX: U6.12 (R1OUT); also elsewhere on the board
RS232_1_TX: U6.11 (T1IN); also elsewhere on the board
RS232_2_RX: U7.12 (R1OUT); also elsewhere on the board
RS232_2_TX: U7.11 (T1IN); also elsewhere on the board
RS232_3_RX: U6.9 (R2OUT); also elsewhere on the board
RS232_3_TX: U6.10 (T2IN); also elsewhere on the board
USB_RX: U8.7 (TXD); also elsewhere on the board
USB_TX: U8.10 (RXD); also elsewhere on the board

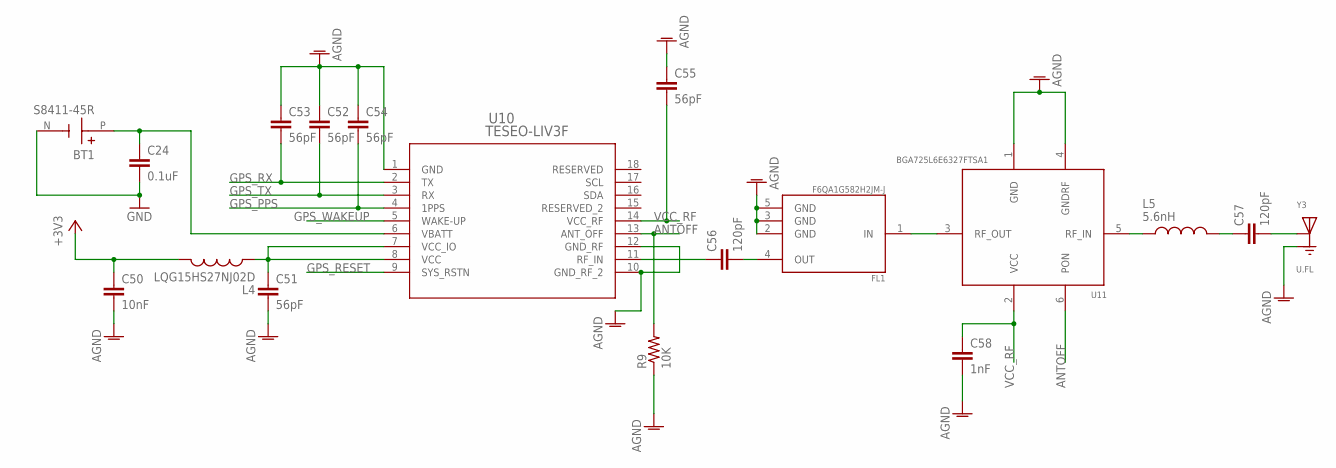
[picture p5: schematic Krakatau Board v1.3.sch, sheet 5]

Parts:
BT1: S8411-45R; BAT_S8411-45R
C24: 0.1uF; CAPC1005X50N-0402-KEMET
C50: 10nF; CAPC1005X50N-0402-KEMET
C51, C52, C53, C54, C55: 56pF; CAPC1005X50N-0402-KEMET
C56, C57: 120pF; CAPC1005X50N-0402-KEMET
C58: 1nF; CAPC1005X50N-0402-KEMET
FL1: F6QA1G582H2JM-J; FIL_F6QA1G582H2JM-J
L4: LQG15HS27NJ02D; INDC1005X55N
L5: 5.6nH; INDC1006X60N
R9: 10K; RESC1005X35N-0402-VISHAYDALE
U10: TESEO-LIV3F; LCC18_9P7X10P1
U11: BGA725L6E6327FTSA1; INF-TSLP-6-2_V_1PRIMARY
Y3: U.FL; HRS_U.FL-R-SMT-1(10)

Connections:
+3V3: C50.1, L4.2; also elsewhere on the board
AGND: C50.2, C51.2, C52.1, C53.1, C54.1, C55.1, C58.2, FL1.2 (GND), FL1.3 (GND), FL1.5 (GND), R9.1, U10.1 (GND), U10.10 (GND_RF_2), U10.12 (GND_RF), U11.1 (GND), U11.4 (GNDRF), Y3.1 (GND), Y3.3 (GND); also elsewhere on the board
ANTOFF: R9.2, U10.13 (ANT_OFF), U11.6 (PON)
GND: BT1.N (-), C24.2; also elsewhere on the board
GPS_PPS: C54.2, U10.4 (1PPS); also elsewhere on the board
GPS_RESET: U10.9 (SYS_RSTN); also elsewhere on the board
GPS_RX: C53.2, U10.2 (TX); also elsewhere on the board
GPS_TX: C52.2, U10.3 (RX); also elsewhere on the board
GPS_WAKEUP: U10.5 (WAKE-UP); also elsewhere on the board
unnamed: C51.1, L4.1, U10.7 (VCC_IO), U10.8 (VCC)
unnamed: C56.2, FL1.4 (OUT)
unnamed: C56.1, U10.11 (RF_IN)
unnamed: FL1.1 (IN), U11.3 (RF_OUT)
unnamed: L5.1, U11.5 (RF_IN)
unnamed: C57.1, L5.2
unnamed: C57.2, Y3.2 (SIG)
VBAT: BT1.P (+), C24.1, U10.6 (VBATT)
VCC_RF: C55.2, C58.1, U10.14 (VCC_RF), U11.2 (VCC)

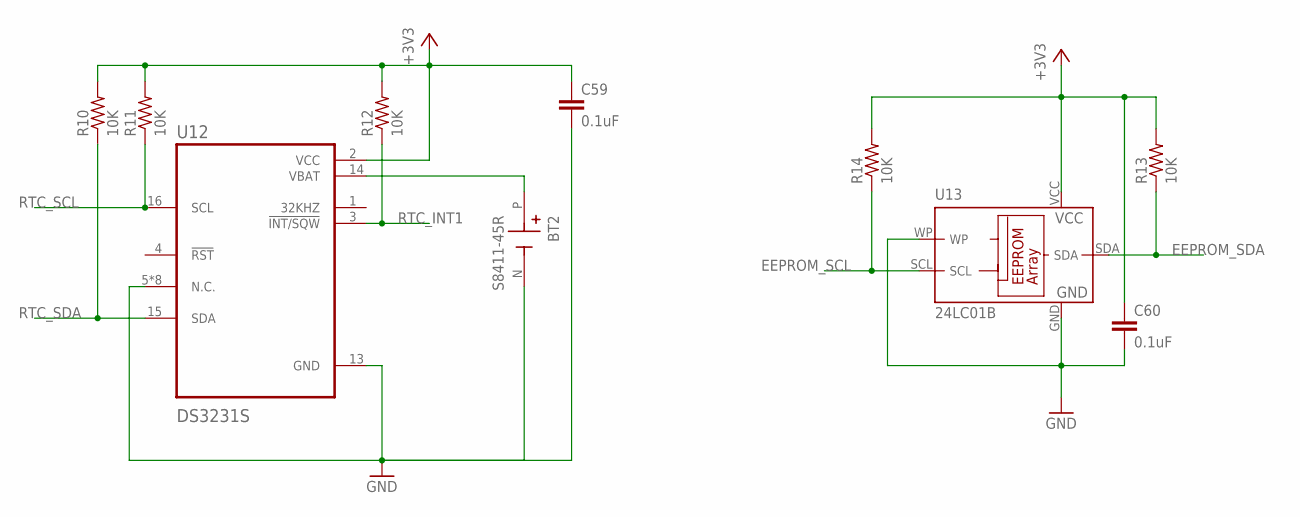
[picture p6: schematic Krakatau Board v1.3.sch, sheet 6]

Parts:
BT2: S8411-45R; BAT_S8411-45R
C59, C60: 0.1uF; CAPC1005X50N-0402-KEMET
R10, R11, R12, R13, R14: 10K; RESC1005X35N-0402-VISHAYDALE
U12: DS3231S; SOIC127P1032X265-16N
U13: 24LC01B; SOT23-5L

Connections:
+3V3: C59.1, C60.1, R10.2, R11.2, R12.2, R13.2, R14.2, U12.2 (VCC), U13.VCC; also elsewhere on the board
EEPROM_SCL: R14.1, U13.SCL; also elsewhere on the board
EEPROM_SDA: R13.1, U13.SDA; also elsewhere on the board
GND: BT2.N (-), C59.2, C60.2, U12.5 (N.C.), U12.6 (N.C.), U12.7 (N.C.), U12.8 (N.C.), U12.9 (N.C.), U12.10 (N.C.), U12.11 (N.C.), U12.12 (N.C.), U12.13 (GND), U13.GND, U13.WP; also elsewhere on the board
unnamed: BT2.P (+), U12.14 (VBAT)
RTC_INT1: R12.1, U12.3 (!INT/SQW); also elsewhere on the board
RTC_SCL: R11.1, U12.16 (SCL); also elsewhere on the board
RTC_SDA: R10.1, U12.15 (SDA); also elsewhere on the board

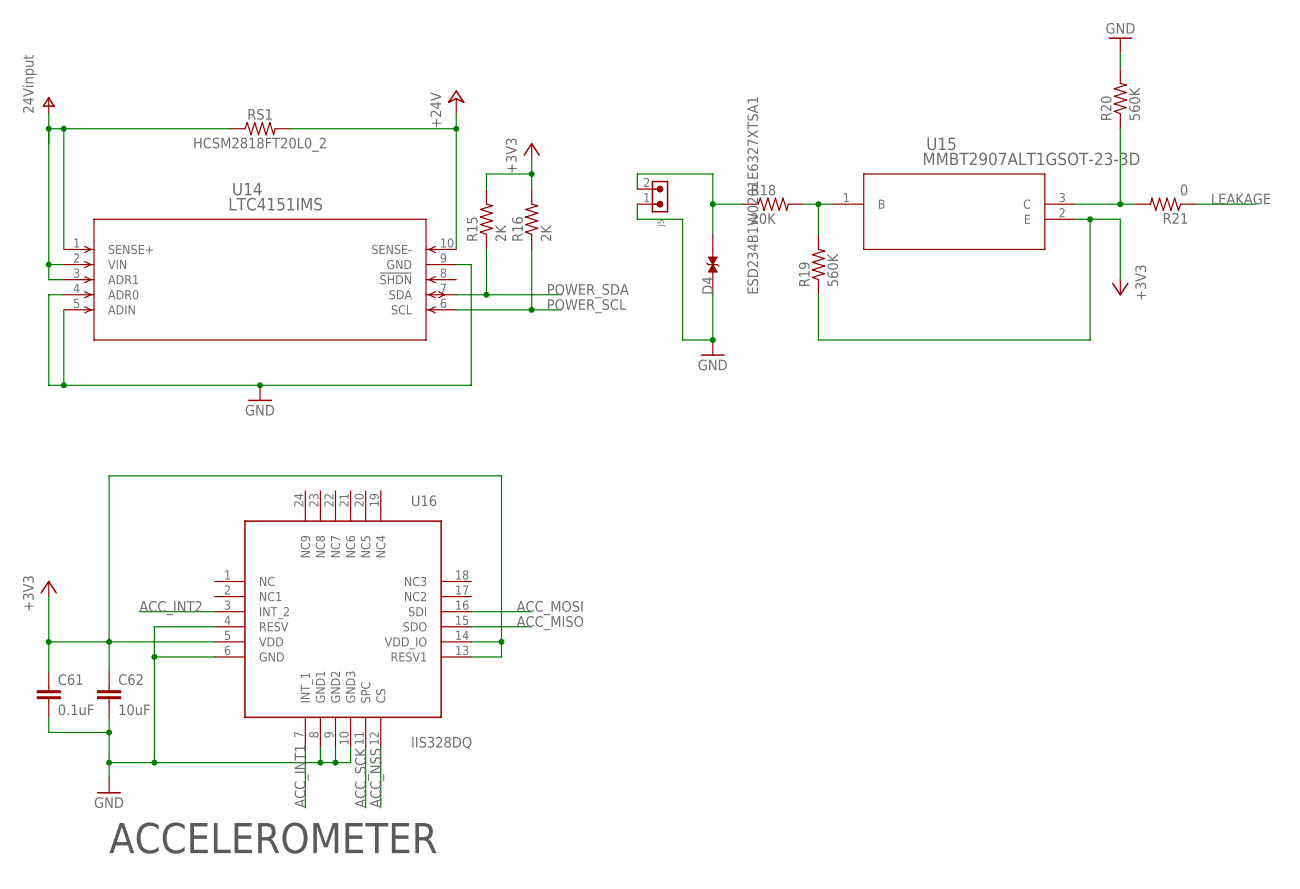
[picture p7: schematic Krakatau Board v1.3.sch, sheet 7]

Parts:
C61: 0.1uF; CAPC1005X50N-0402-KEMET
C62: 10uF; CAPC1005X50N-0402-KEMET
D4: ESD234B1W0201E6327XTSA1; DIODFN58X28X16-2N
J5: 61900211021
R15, R16: 2K; RESC1005X35N-0402-VISHAYDALE
R18: 20K; RESC1005X35N-0402-VISHAYDALE
R19, R20: 560K; RESC1005X35N-0402-VISHAYDALE
R21: 0; RESC1005X35N-0402-VISHAYDALE
RS1: HCSM2818FT20L0_2; RESM7149X165NR
U14: LTC4151IMS; SOP50P490X110-10N
U15: MMBT2907ALT1GSOT-23-3D; SOT95P237X110-3
U16: IIS328DQ; QFN50P400X400X100-24

Connections:
+3V3: C61.1, C62.1, R15.2, R16.2, R19.1, U15.2 (E), U16.5 (VDD), U16.13 (RESV1), U16.14 (VDD_IO); also elsewhere on the board
+24V: RS1.2, U14.10 (SENSE-); also elsewhere on the board
ACC_INT1: U16.7 (INT_1); also elsewhere on the board
ACC_INT2: U16.3 (INT_2); also elsewhere on the board
ACC_MISO: U16.15 (SDO); also elsewhere on the board
ACC_MOSI: U16.16 (SDI); also elsewhere on the board
ACC_NSS: U16.12 (CS); also elsewhere on the board
ACC_SCK: U16.11 (SPC); also elsewhere on the board
GND: C61.2, C62.2, D4.1, J5.1, R20.2, U14.4 (ADR0), U14.5 (ADIN), U14.9 (GND), U16.4 (RESV), U16.6 (GND), U16.8 (GND1), U16.9 (GND2), U16.10 (GND3); also elsewhere on the board
LEAKAGE: R21.1; also elsewhere on the board
unnamed: D4.2, J5.2, R18.1
unnamed: R18.2, R19.2, U15.1 (B)
unnamed: R20.1, R21.2, U15.3 (C)
POWER_SCL: R16.1, U14.6 (SCL); also elsewhere on the board
POWER_SDA: R15.1, U14.7 (SDA); also elsewhere on the board
V+: RS1.1, U14.1 (SENSE+), U14.2 (VIN), U14.3 (ADR1); also elsewhere on the board

Notes on the sheet:
ACCELEROMETER

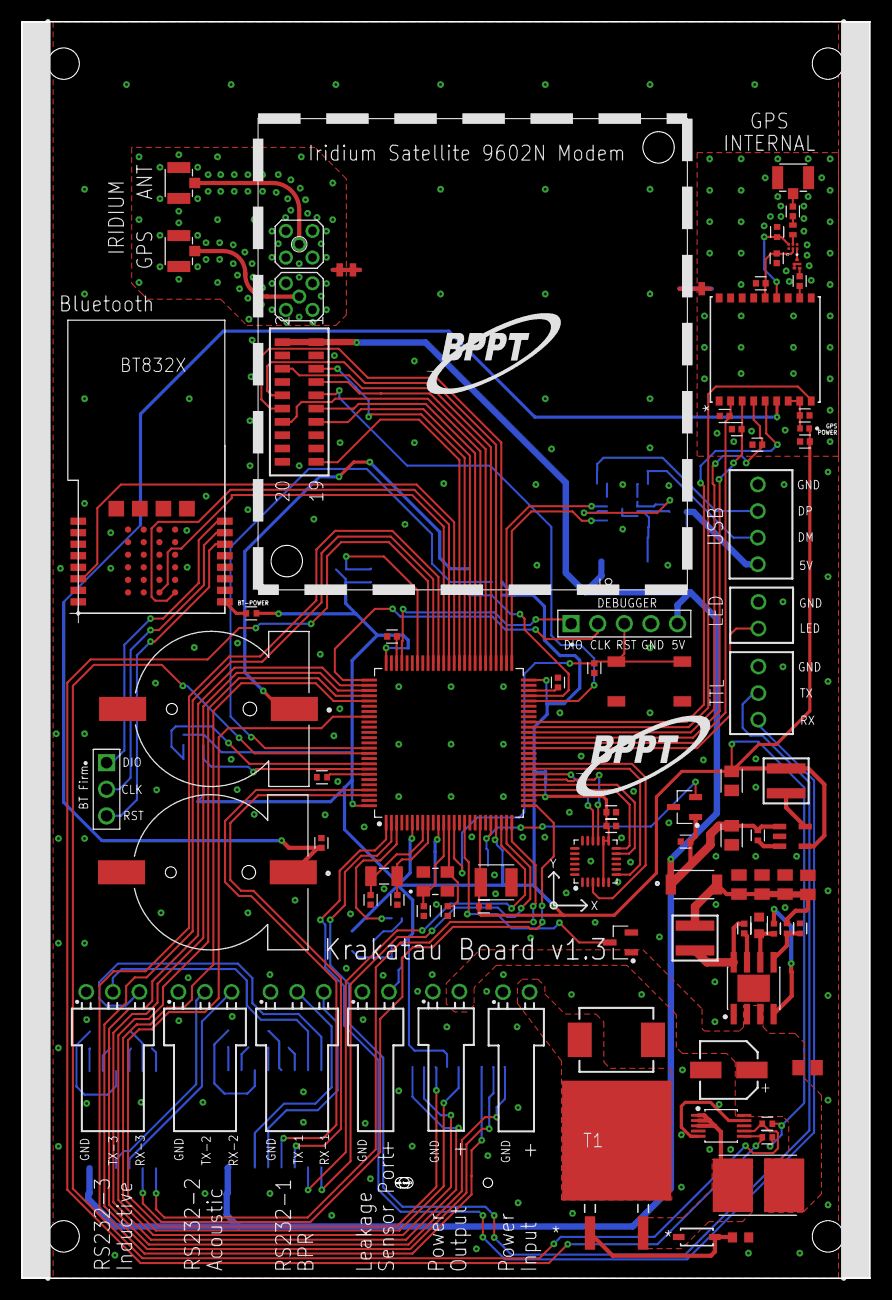
[picture p8: board Krakatau Board v1.3.brd from above]

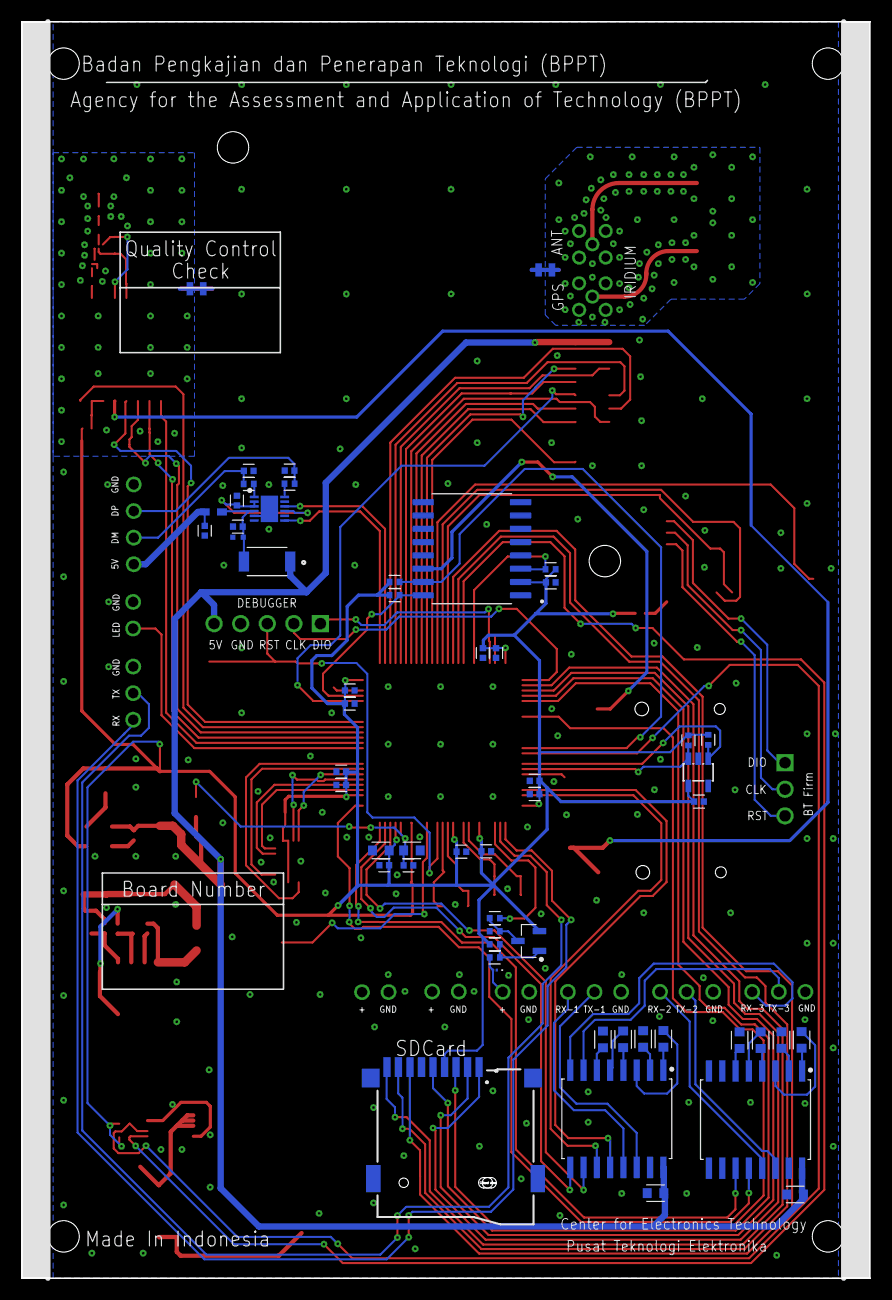
[picture p9: board Krakatau Board v1.3.brd from below]

Board: 2 copper layers, 81.0 x 120.0 mm, 141 parts (55 on the bottom side), 124 nets.
