ihsanalhafiz/Krakatau-Board-v1.3/(commit log)

2020-05-08 update BoM fix cek 08 mei 2020
    [BOM_KrakatauBoardv1.3_Fix.xlsx]
2020-05-09 vias 0.25 min pcbway for 2mm
    [BOM_KrakatauBoardv1.3_Fix.xlsx, Krakatau Board v1.3.brd, Krakatau Board v1.3.sch, PCBWay-BOM KrakatauBoardv1.3.xlsx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]
